rlawnsgud02/2025_NURA/2025nura/ejection.cpp

#include "ejection.h"

// ejection 객체 사용 방법
/*
객체 생성 시 is_ejected safetypin은 기본 파라미터로 초기화됨
사출 type, anglegyro, max_avg_alt, avg_alt, time 모두 0으로 초기화

메인 파일에서 객체 생성 후, 객체이름.eject(euler, alt, mes); 함수만 호출하면 작동함 -> mes는 강제 사출을 위해 추가함

현재 25.07.05 16:20에
코드의 기본적인 틀만 작성했으며 세부적인 코드를 추가하여 구현해야함

클래스로 정의한 이유
24nura의 사출 코드가 너무 방대하여 가독성이 떨어지며 추후 코드 
수정이나 설명, 이해의 측면에서 더욱 효과적이기에 클래스로 구현함

모든 데이터를 pointer로 구현할 수도 있지만(데이터 안정화 보장 가능) 굳이..?


기록 25.07.10
수정 사항
eject_alt의 avg_alt 구현
lunchpin 선언
eject에서 safetypin, lunchpin 조건문 추가

고민 사항
사출 여부와 종류 메시지를 지상국에 보내는데 NMT헤더를 추가하느냐(통신 문제가 생길까봐 안하는게 좋을 것 같음)
아니면 eject이 char pointer를 반환하도록 수정하여 rf.print(문자열);를 구현하느냐
@@@@ 가능한 방안 @@@@
1. 쓰레드끼리 같은 변수를 사용하여 eject의 반환값을 저장하고 rf.print에 해당 변수를 보낸다 -> 전역 변수 사용
2. 쓰레드를 3개로 구현하여 사출과 sd, 통신을 같이 처리한다 -> 쓰레드 3, 4의 메모리를 전부 할당해야 함.

사용 방법
객체 생성 후, eject()가 int를 반환함 -> main파일에서 type에 따라 메시지 작성
eject(servopin, is_ejected, safetypin, launchpin);

type 0 -> 사출 X | type 1 -> 자세 | type 2 -> 고도 | type 3 -> 시간 | type 4 -> 강제 사출

------------------------------------제작 완료------------------------------------ 

<2025.07.15>
ESP32내장 pwm제어 사용

객체 생성 시, 생성자에 사출핀, pwm채널, 안전핀, 발사핀, 사출여부(false)를 파라미터로 설정

setup에서 servo_init 호출 -> initialize 완료 후, 서보가 MAX로 돌아감

loop에서 eject함수 호출 -> 자이로값, 고도값, 타이머, 강제사출 메시지를 파라미터로 설정

자체적으로 값 분석 후, 사출여부 판단 -> eject함수는 int를 반환하며 
0은 사출 X | 1은 자세 | 2는 고도 감소 | 3은 시간 | 4는 강제사출에 해당함

Thank you Gemini!

safetypin, launchpint은 int이므로 생성자 수정 필요함! -> 나중에 ㄱㄱ -> 추가 수정 필요하지만 쉬울 듯?

*/


/*
// 실제
ejection::ejection(int servopin, int8_t ch, int8_t safetypin, int8_t launchpin, bool is_ejected): servopin(servopin), CH(ch), safetypin(safetypin), launchpin(launchpin), is_ejected(is_ejected) {
    type = NO_EJECTION; count = 0; anglegro = 0; max_avg_alt = 0; avg_alt = 0; timer = 0; servo_frequency = 50; pwm_bits = 12; max_duty = (1 << pwm_bits) - 1;
}
*/

// 임시 테스트용
ejection::ejection(int8_t servopin, int8_t ch, bool is_ejected): servopin(servopin), CH(ch), is_ejected(is_ejected) {
    type = NO_EJECTION; count = 0; anglegro = 0; max_avg_alt = 0; avg_alt = 0; timer = 0; 
    Launch_time = 0; servo_frequency = 50; pwm_bits = 12; max_duty = (1 << pwm_bits) - 1;
}

void ejection::servo_init() {
    ledcSetup(CH, servo_frequency, pwm_bits);
    delay(10);
    ledcAttachPin(servopin, CH);
    delay(10);
    servo_write(MAX);
    Serial.println("Ejection Servo Initialize complete!");
}


bool ejection::eject_gyro(float anglegro) {
    if (anglegro > 70) {
        servo_write(MIN);
        type = GYRO_EJECTION;
        return true;
    }
    return false;
}

bool ejection::eject_alt(double alt) {
    BUF_avg(alt);

    max_avg_alt = (avg_alt >= max_avg_alt) ? avg_alt : max_avg_alt;

    if (max_avg_alt - avg_alt > 3) {
        servo_write(MIN);
        type = ALT_EJECTION;
        return true;
    }
    return false;
}

bool ejection::eject_time() {
    if (timer >= 10000 + Launch_time) {
        servo_write(MIN);
        type = TIME_EJECTION;
        return true;
    }
    return false;
}

int8_t ejection::eject_manual() {
    servo_write(MIN);
    return MANUAL_EJECTION;
}

int ejection::eject(float anglegro, double alt, uint32_t time, int8_t msg) { // msg -> GCS에서 통신으로 사출하기 위해
/*
    발사 시점 즉, launch pin이 0이 인식된 시점을 기점으로 파악. 
        launchTime = parachute_data.timestamp;
        if(parachute_data.timestamp > launchTime + 3500){
    3.5초 이후부터 eject 판단
    한번 1 또는 2의 신호를 주면 해당 신호를 유지. 이후 시간사출에 의해서 3으로 덮어씌워지는건 상관 없음. 작년에도 그랬음.
*/
    timer = time;

    if (type == NO_EJECTION) {
        // if (timer % 1000 < 200) {
        //     is_ejected = (msg == 1) ? (type = eject_manual(), true) : ((type = 0), eject_gyro(anglegro) || eject_alt(alt) || eject_time());
        // }
        // else {
        //     is_ejected = (msg == 1) ? (type = eject_manual(), true) : ((type = 0), eject_alt(alt) || eject_time());
        // }
        if (timer > 3500 + Launch_time) {
            is_ejected = (msg == 1) ? (type = eject_manual(), true) : ((type = 0), eject_gyro(anglegro) || eject_alt(alt) || eject_time());

            // timer 사출 배제
            // is_ejected = (msg == 1) ? (type = eject_manual(), true) : ((type = 0), eject_gyro(anglegro) || eject_alt(alt));

            
            // 고도사출만 테스트용
            // is_ejected = (msg == 1) ? (type = eject_manual(), true) : ((type = 0), eject_alt(alt));

            // 자세 사출만 테스트용
            // is_ejected = (msg == 1) ? (type = eject_manual(), true) : ((type = 0), eject_gyro(anglegro));

        }

        return type;

    }
    else {
        return type;
    }
}


void ejection::BUF_avg(double alt) {
    avg_alt += (alt - calc_BUF[count]) / MAX_BUF;
    calc_BUF[count] = alt;
    count = (count + 1) % MAX_BUF;
}


void ejection::servo_write(int pulse) {
    double period = 1000000.0 / servo_frequency;
    uint32_t duty = (uint32_t)(((double)pulse / period) * (double)max_duty);

    ledcWrite(CH, duty);
}

void ejection::set_launch_time(uint32_t time) {
    Launch_time = time;
}
