rlawnsgud02/2025_NURA/2025nura/BMP390L.h

#ifndef BMP390L_H
#define BMP390L_H

#include "bmp3.h"
#include "baro_I2C.h"

#define BMP3XX_DEFAULT_ADDRESS (0x77) ///< The default I2C address

class BMP390L {
private:

    I2C *i2c_dev = NULL; ///< Pointer to I2C bus interface

    float Temperature;
    float Pressure;
    float Altitude;
    float AltitudeBias;
    

    bool _filterEnabled, _tempOSEnabled, _presOSEnabled, _ODREnabled;

    unsigned long _meas_end;

    struct bmp3_dev the_sensor;

    bool _init();

    

public:
 
    BMP390L();
    
    bool begin_I2C(uint8_t addr = BMP3XX_DEFAULT_ADDRESS, int SDA = -1, int SCL = -1);

    bool setTemperatureOversampling(uint8_t os);
    bool setPressureOversampling(uint8_t os);
    bool setIIRFilterCoeff(uint8_t fs);
    bool setOutputDataRate(uint8_t odr);

    bool performReading();

    float readTemperature();
    float readPressure();
    float readAltitude(int8_t portion = 1);
    float readAltitudeBias(); //실제로는 필요 없음
    void set_Altitude(float seaLevel);

    bool set_AltitudeBias();
    void getTempPressAlt(float &temp, float &press, float &altitude);
    bool isDataReady();


};



#endif // BMP390L_H
