rlawnsgud02/2025_NURA/(commit log)

2025-03-20 2025.03.20 23:56 update. GPS 통신 방식 변경 필요요
2025-03-24 GPS를 hardwareserial에서 softwareseiral로 전환하는 대공사 진행 완료료
2025-03-26 2025.03.26 16:29 IMU, GPS 완성
2025-03-26 Barometric code by 김랑현
2025-03-27 Barometric 수정 필요요
2025-03-30 barometric 완성
2025-05-06 Refactor SDLogger and UbxGPS to improve structure and functionality; update pin definitions and remove unused code
2025-05-06 Refactor SDLogger and UbxGPS for improved structure and functionality; update pin definitions and enhance GPS data handling
2025-06-03 main으로 merge 전 정리
2025-06-30 sd 카드 작동 버전
2025-07-01 sd카드 진짜 동작 코드
2025-07-04 NMT & Packet 초기 구현 완료
2025-07-05 GPS I2C로 변경. Ejection 코드 작성 시작.
2025-07-05 Github 협업 테스트용 저장
2025-07-05 GPS I2C 구현 및 SD카드 저장 완전 성공
2025-07-05 ejection 변경
2025-07-07 Fix serial initialization and enable IMU data printing in setup
    [2025nura.ino]
2025-07-09 Packet Prototype
2025-07-09 packet Prototype_ver2.
2025-07-09 packet Prototype_ver3.
2025-07-11 Packet 통신 성공 버전.
2025-07-15 사출 코드 98% 완성
2025-07-15 PCB 설계에 맞게 핀번호 재정립 및 ino 파일 내용 정리. Servo 관련 레퍼런스 코드 첨부
2025-07-15 랑현이 ejection 코드 날라가서 복구
2025-07-16 Mutex에서 Queue 구조로 변환 전 push
2025-07-17 RTOS Queue 구조 1차 완성
2025-07-17 Queue 구조 완성본 ver.2 안정성 상당히 좋음
2025-07-17 사소한 수정
2025-07-18 ejection 변경요청 구현
2025-07-18 Stack Size 조정
2025-07-18 대소문자 에러 해결
2025-07-18 카나드 제어기 구현중
2025-07-18 yaw 값에 따른 서보모터 구동 성공. 파라미터 튜닝 필요.
2025-07-20 ino 맨아래를 확인하시오. (packet - launch 추가 완료)
2025-07-20 확인하세요.
    packet 추가 수정 완
    [packet_2025.cpp]
2025-07-21 launch 관련 파라미터 추가. 스레드 불안정성 증가로 인한 스레드 안정화 필요.
2025-07-22 시스템 안정성 확보 성공
2025-07-22 주석 및 코드 정리
2025-07-22 코드 수정
2025-07-22 packet 수정완
2025-07-22 카나드 롤 제어 구동 성공. 어느정도 적당한 PD Gain값 찾기 성공
2025-07-23 BUF_avg함수 연산량 줄이기 - 티끌모아 태산
2025-07-23 pd 튜닝중
2025-07-24 제어 Hz 30까지 증가. ATTALT 스레드가 원인이었으며 BINARY 데이터 출력으로 변경 후 해결 됨.
2025-07-24 pd 게인 찾는 중, pole 지점에서 서보 급 기동 방지용 안전장치 추가
2025-07-24 제어 안전장치 수정
2025-07-24 2025.07.25 시험발사 코드
2025-07-25 2025.07.26 시험 발사용 코드
2025-07-26 2025.07.26 시험발사 전 마지막 수정
    [2025nura.ino]
2025-07-28 2025.07.26 시험발사 발사장 수정 버전
    [2025nura.ino]
2025-07-28 제어문 pole 지점 문제 해결 시도. GCS의 GPS 문제 해결
2025-07-29 센서의 180~-180 범위에서 pole이 발생하여 제어가 튀는 현상 해결
2025-07-29 2025.07.30 시험발사용 세팅 적용
2025-07-31 2025.07.30 시험발사 당일 세팅
2025-08-03 Canard 핀 별 define 추가
2025-08-07 2025.08.08 발사대회 전 파라미터 업데이트
2025-08-20 2025.08.09 발사대회 당일 파라미터 업데이트
2025-08-20 github 정리중
