rlawnsgud02/2025_NURA/images/pcb1.jpg

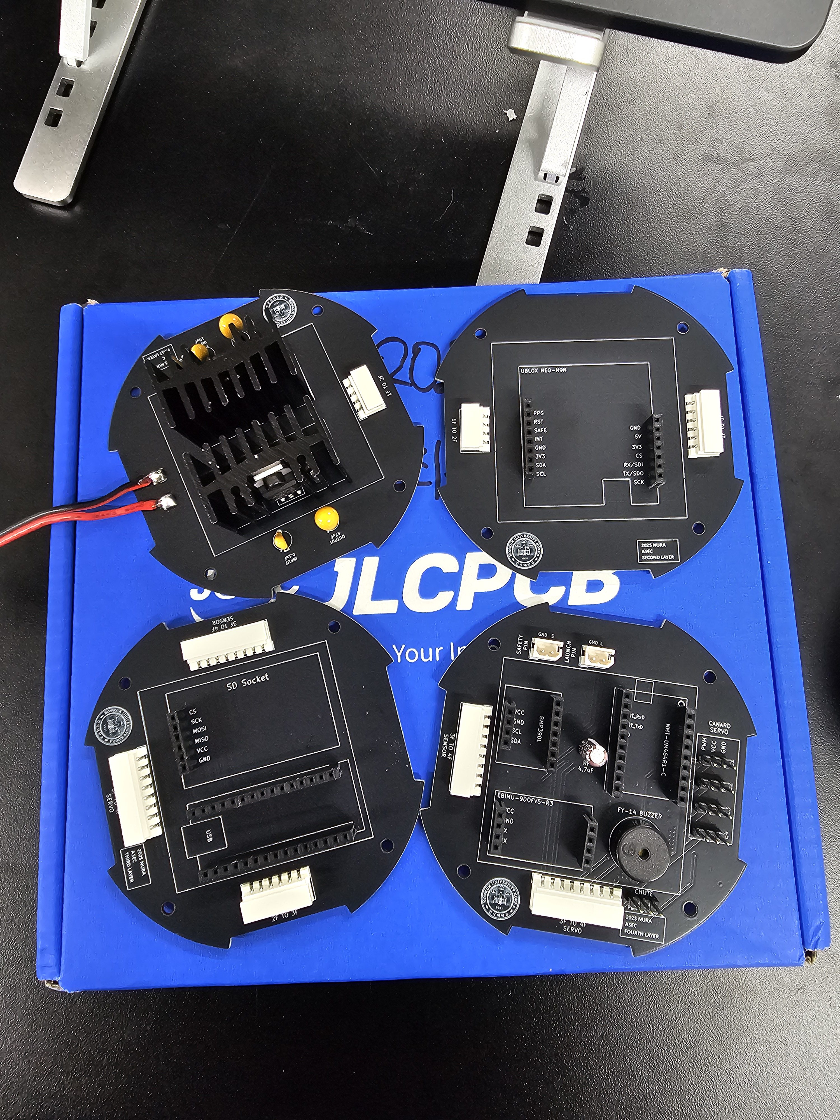
[picture p1: images/pcb1.jpg]
images/pcb1.jpg
