rlawnsgud02/2025_NURA/images/avionics_module.jpg

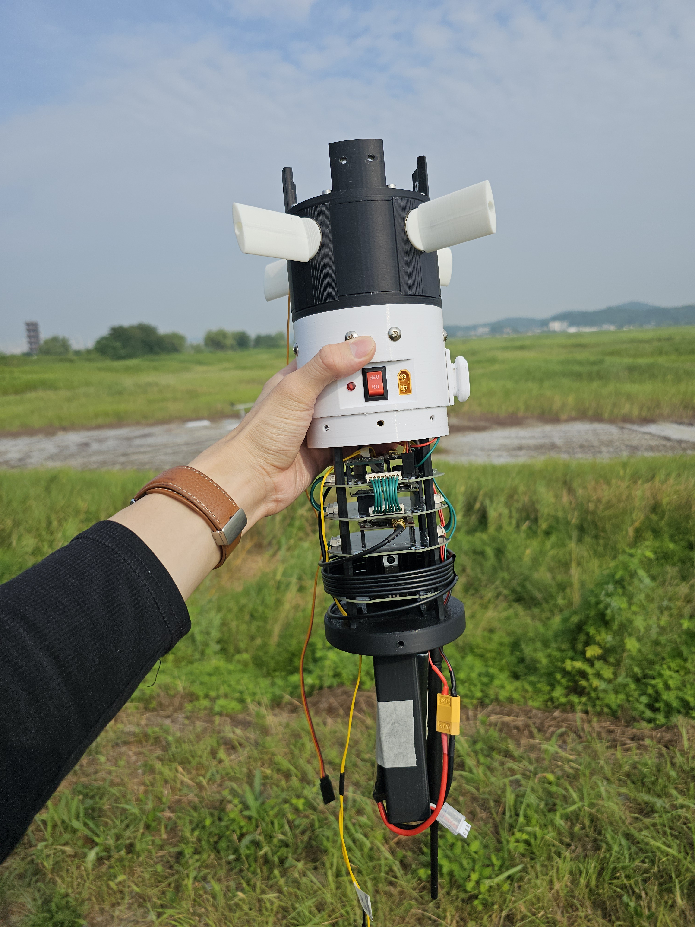
[picture p3: images/avionics_module.jpg]
images/avionics_module.jpg
